Hiro-Watcher/Simple-DIY-automatic-fish-feeder/SCHEMATIC/circuit_image_V2.png

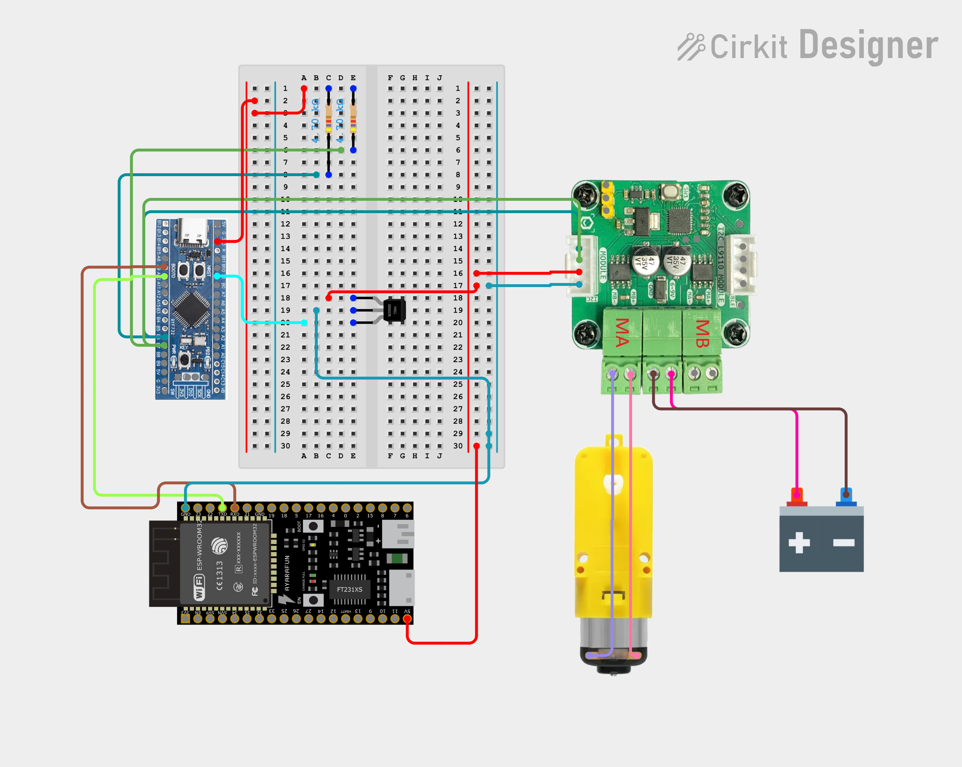
SCHEMATIC/circuit_image_V2.png
