Hiro-Watcher/Simple-DIY-automatic-fish-feeder/SCHEMATIC/circuit_image_V3.png

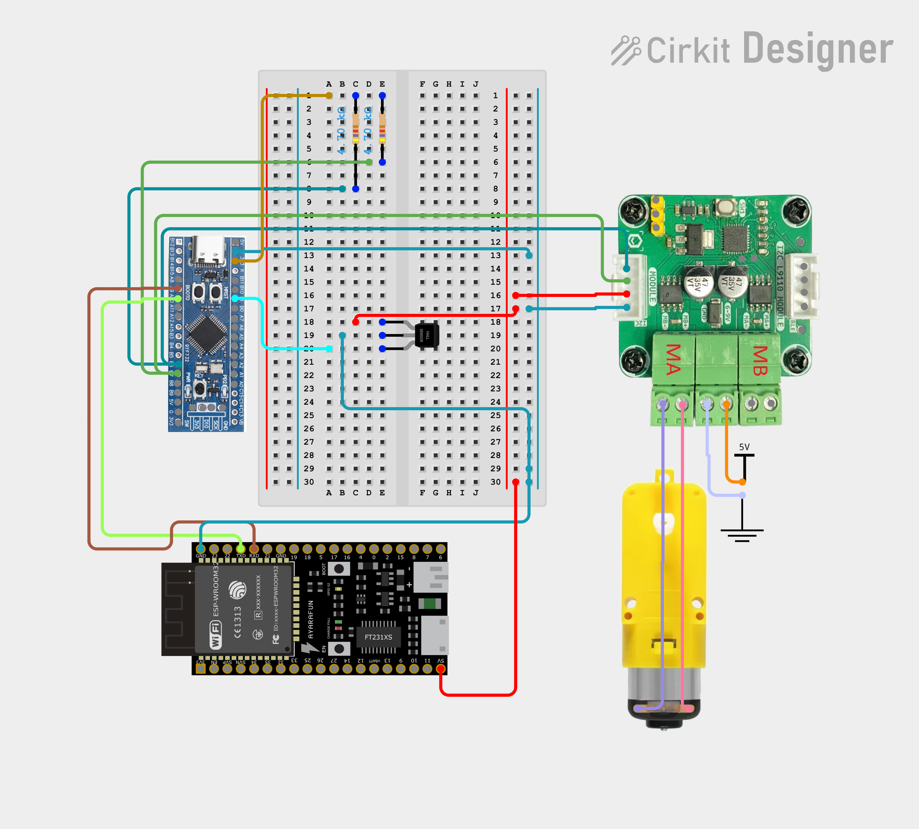
SCHEMATIC/circuit_image_V3.png
