Hiro-Watcher/Simple-DIY-automatic-fish-feeder/SRC/main.c

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
/* Includes ------------------------------------------------------------------*/
/* USER CODE BEGIN Header */
/**
  * @file           : main.c
  * @brief          : Main program body - Automatic Fish Feeder (Blue Pill)
  */
/* USER CODE END Header */

#include "main.h"
#include <stdio.h>
#include <string.h>

/* USER CODE BEGIN PD */
#define MKE_M17_ADDR (0x40 << 1) // 7-bit I2C address 0x40 shifted left for STM32 HAL
/* USER CODE END PD */

I2C_HandleTypeDef hi2c1;
UART_HandleTypeDef huart1;

/* USER CODE BEGIN PV */
uint8_t rx_buffer[32];
uint8_t rx_index = 0;
char time_string[32];
uint8_t data_ready = 0;
uint32_t last_fed_tick = 0; // Cooldown tracking
const uint32_t COOLDOWN_MS = 600000; // 10 minutes rest
int current_hour = -1;
int current_minute = -1;

// Feeding Schedule (24-hour format)
typedef struct {
    int hour;
    int minute;
} FeedingTime;

FeedingTime schedule[] = {
    { 8, 0 },   // Morning feed: 08:00 AM
    { 18, 0 },  // Evening feed: 06:00 PM
    { 0, 8 },   // Test entries
    { 0, 5 },
    { 0, 10 },
    { 0, 14 },
    { 0, 18 },
    { 3, 22 },
    { 3, 26 },
    { 3, 30 },
    { 3, 34 },
	{ 3, 37 },
	{ 3, 42 },
	{ 1, 14 },
	{ 4, 5 },
	{ 10, 47 },
	{ 11, 01 },
	{ 11, 04 },
	{ 10, 54 }
};
int num_feedings = sizeof(schedule) / sizeof(schedule[0]);
/* USER CODE END PV */

void SystemClock_Config(void);
static void MX_GPIO_Init(void);
static void MX_USART1_UART_Init(void);
static void MX_I2C1_Init(void);

/* USER CODE BEGIN PFP */
void execute_feed_cycle(void);
void motor_set_speed(uint8_t channel, int8_t speed);
int time_to_minutes(int hour, int minute);
uint8_t is_in_window(int current_total_min, int scheduled_hour, int scheduled_min);
/* USER CODE END PFP */

int main(void)
{
  HAL_Init();
  SystemClock_Config();

  MX_GPIO_Init();
  MX_USART1_UART_Init();
  MX_I2C1_Init();

  /* USER CODE BEGIN 2 */
  HAL_UART_Receive_IT(&huart1, &rx_buffer[rx_index], 1);
  /* USER CODE END 2 */

  while (1)
  {
      if (data_ready) {
          data_ready = 0; // Clear UART flag

          // Parse time string received from ESP32 (handles both "HH:MM" or full timestamps)
          int parsed = 0;
          if (strchr(time_string, '-')) {
              // Full timestamp format: "YYYY-MM-DD HH:MM:SS" -> skip date
              int year, month, day, sec;
              parsed = sscanf(time_string, "%d-%d-%d %d:%d:%d", &year, &month, &day, &current_hour, &current_minute, &sec);
              if (parsed < 5) parsed = 0; else parsed = 2; // We got hour and minute
          } else {
              // Short format: "HH:MM"
              parsed = sscanf(time_string, "%d:%d", &current_hour, &current_minute);
          }

          if (parsed == 2) {
              int current_total_min = time_to_minutes(current_hour, current_minute);

              // Check if 10-minute cooldown since last feed has elapsed
              if ((HAL_GetTick() - last_fed_tick) >= COOLDOWN_MS || last_fed_tick == 0) {

                  for (int i = 0; i < num_feedings; i++) {
                      if (is_in_window(current_total_min, schedule[i].hour, schedule[i].minute)) {

                          // Execute feed cycle
                          execute_feed_cycle();

                          // Record time tick to activate 10-minute cooldown
                          last_fed_tick = HAL_GetTick();
                          break; // Exit schedule loop
                      }
                  }
              }
          }
      }
  }
}

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
/* USER CODE BEGIN 4 */
int time_to_minutes(int hour, int minute) {
    return (hour * 60) + minute;
}

uint8_t is_in_window(int current_total_min, int scheduled_hour, int scheduled_min) {
    int scheduled_total_min = time_to_minutes(scheduled_hour, scheduled_min);
    int diff = current_total_min - scheduled_total_min;
    return (diff >= -10 && diff <= 10);
}

// Helper to send I2C speed command to MKE-M17 motor driver using defined macro
void motor_set_speed(uint8_t channel, int8_t speed) {
    uint8_t data[2] = {channel, (uint8_t)speed};
    if (HAL_I2C_Master_Transmit(&hi2c1, MKE_M17_ADDR, data, 2, 100) != HAL_OK) {
        // Handle transmission error or log debugging state
    }
}

void execute_feed_cycle(void) {
    // 1. Turn ON motor via I2C (Channel 1, Speed = 150)
    motor_set_speed(1, 150);

    uint32_t start_tick = HAL_GetTick();
    uint32_t timeout_ms = 10000; // 10-second safety timeout

    // 2. Clearance phase: If starting on a magnet (LOW), wait until it leaves (HIGH)
    while (HAL_GPIO_ReadPin(HALL_SENSOR_GPIO_Port, HALL_SENSOR_Pin) == GPIO_PIN_RESET) {
        if ((HAL_GetTick() - start_tick) > timeout_ms) break;
        // NO HAL_Delay here to prevent missing fast edges
    }

    // 3. Rotation phase: Wait until the magnet sweeps past and triggers the sensor (LOW)
    while (HAL_GPIO_ReadPin(HALL_SENSOR_GPIO_Port, HALL_SENSOR_Pin) == GPIO_PIN_SET) {
        if ((HAL_GetTick() - start_tick) > timeout_ms) {
            break; // Stop motor if jammed
        }
        // NO HAL_Delay here! Continuous polling catches fast magnetic pulses.
    }

    // 4. Turn OFF motor via I2C immediately (Speed = 0)
    motor_set_speed(1, 0);
}

// UART Interrupt Callback to capture streaming time data
void HAL_UART_RxCpltCallback(UART_HandleTypeDef *huart) {
    if (huart->Instance == USART1) {
        if (rx_buffer[rx_index] == '\n' || rx_index >= sizeof(rx_buffer) - 1) {
            // Null-terminate and strip potential trailing '\r'
            if (rx_index > 0 && rx_buffer[rx_index - 1] == '\r') {
                rx_buffer[rx_index - 1] = '\0';
            } else {
                rx_buffer[rx_index] = '\0';
            }
            strcpy(time_string, (char *)rx_buffer);
            rx_index = 0;
            data_ready = 1;
        } else {
            rx_index++;
        }
        HAL_UART_Receive_IT(&huart1, &rx_buffer[rx_index], 1);
    }
}
/* USER CODE END 4 */

void Error_Handler(void)
{
  __disable_irq();
  while (1) {}
}
#ifdef USE_FULL_ASSERT
/**
  * @brief  Reports the name of the source file and the source line number
  *         where the assert_param error has occurred.
  * @param  file: pointer to the source file name
  * @param  line: assert_param error line source number
  * @retval None
  */
void assert_failed(uint8_t *file, uint32_t line)
{
  /* USER CODE BEGIN 6 */
  /* User can add his own implementation to report the file name and line number,
     ex: printf("Wrong parameters value: file %s on line %d\r\n", file, line) */
  /* USER CODE END 6 */
}
#endif /* USE_FULL_ASSERT */
