Hiro-Watcher/Simple-DIY-automatic-fish-feeder/(commit log)

2026-11-05 code for the stm32 board
2026-11-05 code for the esp32
    purpose is to fetch time to the stm32 board. change time interval is easy, it is the last line.
    currently it is set to every 30 seconds
2026-11-05 how to wire the board
    I don't think there is anything here that is optional, add but don't remove. the diode is necessary to avoid emp
2026-11-05 how to wire the whole things(not breadboard)
    in specific. black rectangle are the fan. and the while box at the top at the pan is where to attach the magnetic cube to
2026-11-05 the schematic to assemble on the breadboard
2026-11-09 Revise README with component updates and clarifications
    Updated the README to reflect changes in components and added explanations for using L9110 and UART.
2026-11-09 Refactor main.c for I2C motor control
    Refactor main.c to implement I2C motor control and improve feeding schedule handling.
2026-11-09 Add files via upload
    how to wire it
2026-11-10 Add ESP32 NTP time synchronization code
    This code connects to WiFi, synchronizes time using NTP, and sends the current time to a secondary serial port every 30 seconds.
2026-11-10 Refactor feeding schedule and UART callback
    Updated feeding schedule and improved UART handling.
2026-11-10 Rename BÁO CÁO DỰ ÁN.docx to REPORT/BÁO CÁO DỰ ÁN.docx
2026-11-13 Add ESP32-S standalone fish feeder implementation
    This file implements an automatic fish feeder using an ESP32-S microcontroller, integrating Wi-Fi connectivity, scheduling, and motor control.
2026-11-13 Revise README for clarity and additional details
    Updated README to improve clarity and detail about the project, including version comparisons, wiring instructions, setup steps, and troubleshooting tips.
2026-11-13 Update wiring image reference in README.md
2026-11-13 Change wiring image reference from wiringscheme.png to circuit_image.png
    Updated image reference in setup instructions.
2026-11-13 Modify feeding schedule and motor settings
    Updated feeding schedule slots and motor parameters. Adjusted timeout settings and added post-trigger run duration.
