Hiro-Watcher/Simple-DIY-automatic-fish-feeder/(notices)

Notices in the files:
SRC/main.c:
Copyright (c) 2026 STMicroelectronics.
All rights reserved.
This software is licensed under terms that can be found in the LICENSE file
